tthanhtung1140003/vision-guided-tactile-gripper/firmware/readme.md

# Firmware

This folder contains the low-level firmware for the two STM32-based controllers in the vision-guided tactile gripper system:

- **gantry/**: Firmware for the 3-axis gantry CNC controller (STM32F103C8Tx).
- **gripper/**: Firmware for the parallel gripper controller (STM32 Blackpill).

Both are responsible for real-time motion control, communication, and safety features.

## Overview

| Controller | MCU | Communication | Main Functions | Project Type |
|---|---|---|---|---|
| Gantry | STM32F103C8Tx | USB Serial (from Laptop GUI) | Homing, jogging, motion planning, limits, error handling | STM32CubeIDE (.ioc) |
| Gripper | STM32 Blackpill  | USB Serial (from Raspberry Pi) | Grip/release, PID position/force, encoder reading | Arduino (.ino) |

## Folder Structure

```text
gantry/
├── App/                      # Application layer (custom logic)
│   ├── comm/                 # Serial communication protocol
│   │   ├── comm.c
│   │   └── comm.h
│   ├── driver/               # Hardware drivers
│   │   ├── driver.c
│   │   └── driver.h
│   ├── error/                # Error management
│   │   ├── error.c
│   │   └── error.h
│   ├── homing/               # Homing sequence
│   │   ├── homing.c
│   │   └── homing.h
│   ├── jog/                  # Jogging mode
│   │   ├── jog.c
│   │   └── jog.h
│   ├── limit/                # Limit switch handling
│   │   ├── limit.c
│   │   └── limit.h
│   ├── motion/               # Motion control core
│   │   ├── motion.c
│   │   └── motion.h
│   ├── protocol/             # Command parser
│   │   ├── protocol.c
│   │   └── protocol.h
│   ├── system/               # System init & tick
│   │   ├── system.c
│   │   └── system.h
│   ├── serial_rx.c
│   ├── serial_rx.h
│   ├── tick_1ms.c
│   └── tick_1ms.h
├── Core/                     # STM32Cube generated code
│   ├── Inc/                  # HAL headers
│   ├── Src/                  # HAL implementation
│   └── Startup/              # Startup assembly
├── Drivers/                  # CMSIS & STM32 HAL
├── Gantry Controller v10.ioc # CubeMX project file
├── STM32F103C8TX_FLASH.ld    # Linker script
└── Test.launch               # Debug configuration (optional)

gripper/
└── gripper.ino               # Main sketch: USB Serial, motor control, PID, encoder
```

## Communication Protocols

- **Gantry** → Receives G-code-like commands via USB Serial from Laptop GUI.  
  See: [protocols/serial_gantry_protocol.md](../protocols/serial_gantry_protocol.md)

- **Gripper** → Receives ASCII commands via USB Serial from Raspberry Pi.  
  See: [protocols/usb_gripper_protocol.md](../protocols/usb_gripper_protocol.md)

## Build & Flash Instructions

### For gantry/ (STM32CubeIDE)
1. Open `Gantry Controller v10.ioc` in STM32CubeIDE.
2. Generate code (if needed).
3. Build project (Ctrl+B).
4. Connect ST-Link → Debug/Run (F11) or Flash (hammer icon).

### For gripper/ (.ino)
1. Open `gripper.ino` in Arduino IDE (with STM32 core installed).
2. Select board (Generic STM32F1 series or Blackpill variant).
3. Select USB port → Upload.

**Note**: If using PlatformIO instead, create `platformio.ini` in each subfolder.

## Dependencies
- STM32Cube HAL (F1 series)
- CMSIS Core
- USB Device Library (for Serial on gripper, if implemented)
- Arduino STM32 core (for gripper.ino)

## Notes
- Gantry uses 1ms tick for precise timing (`tick_1ms.c`).
- All safety features (limits, error recovery, homing) are implemented in `App/` layer.
- Firmware is tightly coupled with hardware (pinout in `gpio.h` / `main.h`).

For detailed command format, error codes, and baudrate → refer to `protocols/` folder.

Firmware version: v1.0 (March 2026)  
Questions? Contact: tung.ntt215887@sis.hust.edu.vn
