tthanhtung1140003/vision-guided-tactile-gripper/protocols/serial_gantry_protocol.md

# Serial Gantry Protocol (Laptop → STM32)

G-code style:

- HOME
- G0 X100 Y200 Z50 F500
- JOG X+10
- STOP
- ACK
