tthanhtung1140003/vision-guided-tactile-gripper/docs/images/force_regression.png

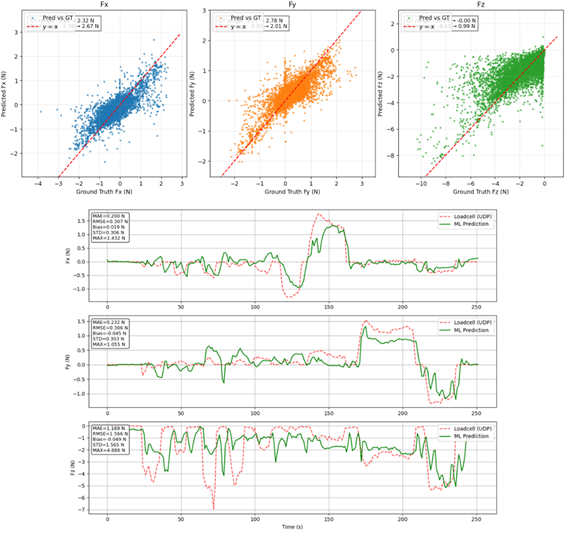
docs/images/force_regression.png
