tthanhtung1140003/vision-guided-tactile-gripper/docs/images/state_machine.png

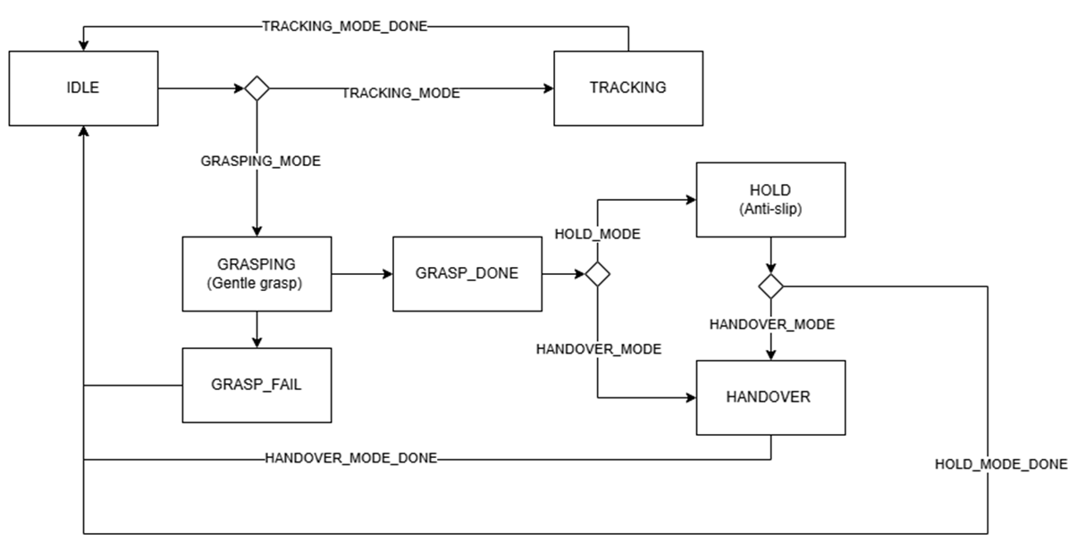
docs/images/state_machine.png
