tthanhtung1140003/vision-guided-tactile-gripper/laptop_gui/BG.png

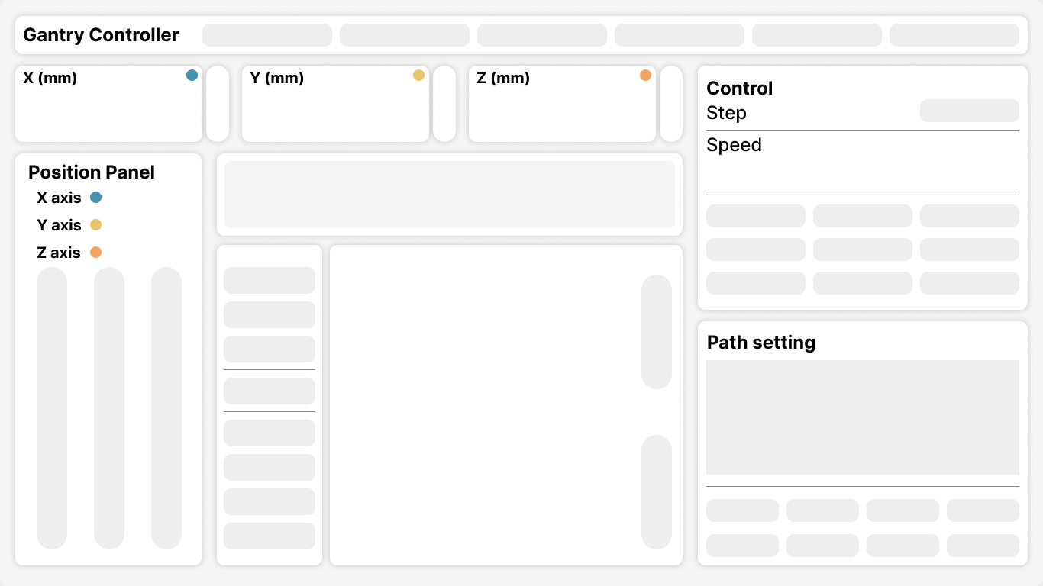
laptop_gui/BG.png
