tthanhtung1140003/vision-guided-tactile-gripper/model_train/pi_mlp_train/mlp_fcnn_style.png

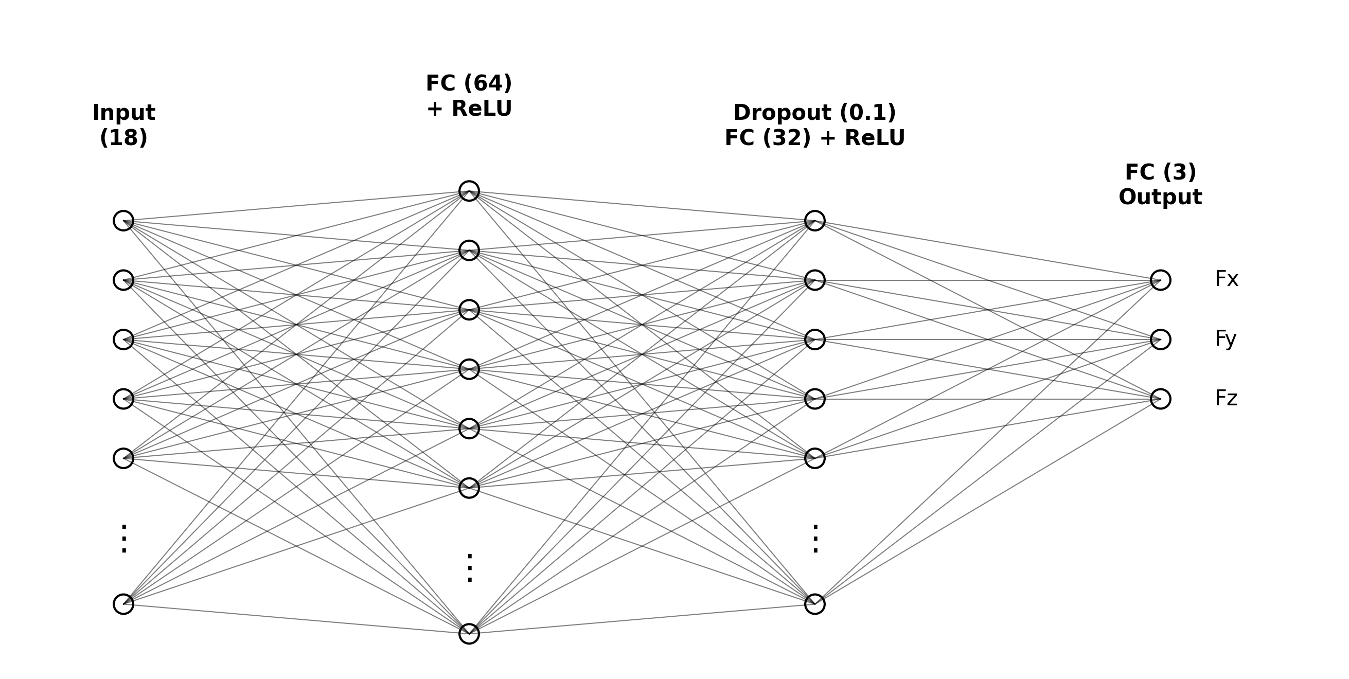
model_train/pi_mlp_train/mlp_fcnn_style.png
