tthanhtung1140003/vision-guided-tactile-gripper/model_train/pi_mlp_train/training_curve.png

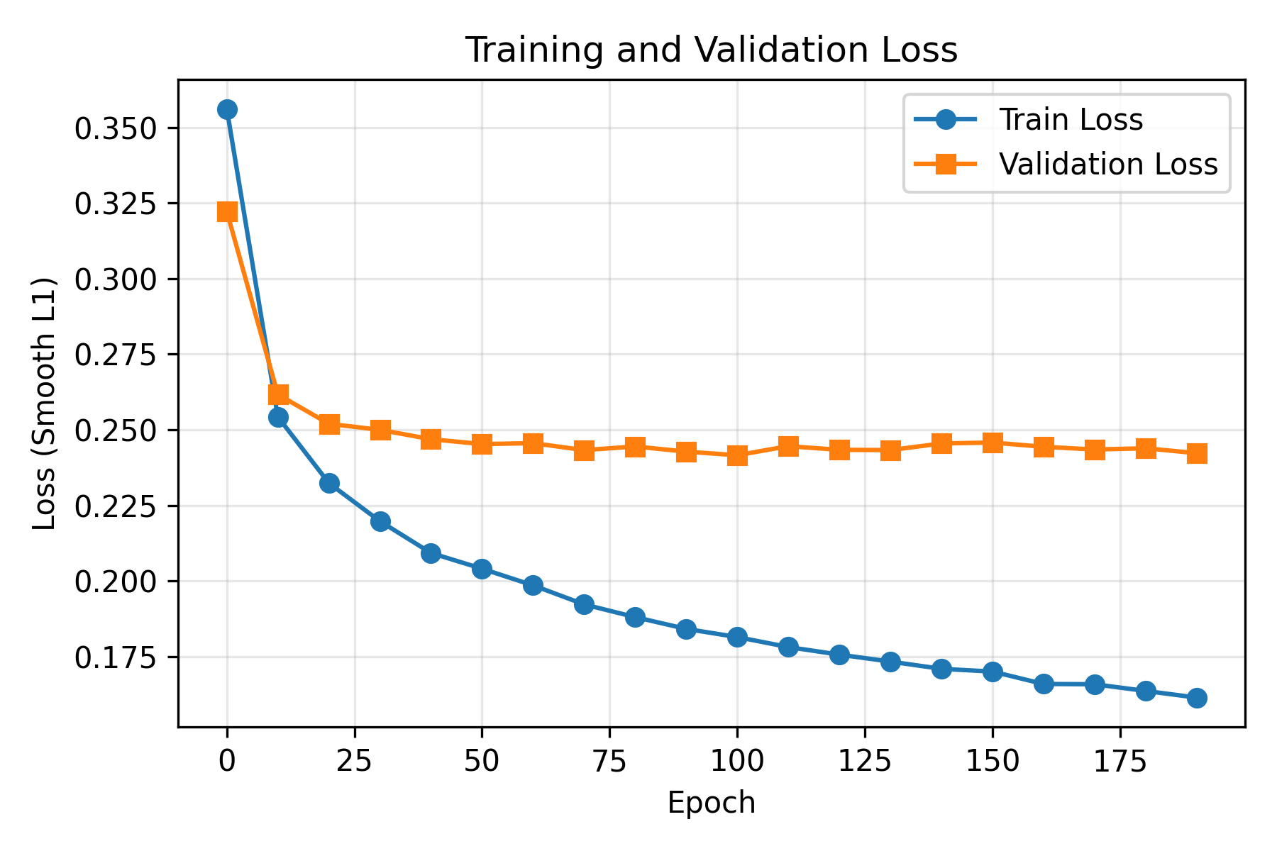
model_train/pi_mlp_train/training_curve.png
