tthanhtung1140003/vision-guided-tactile-gripper/docs/images/gripper_assembly.png.jpg

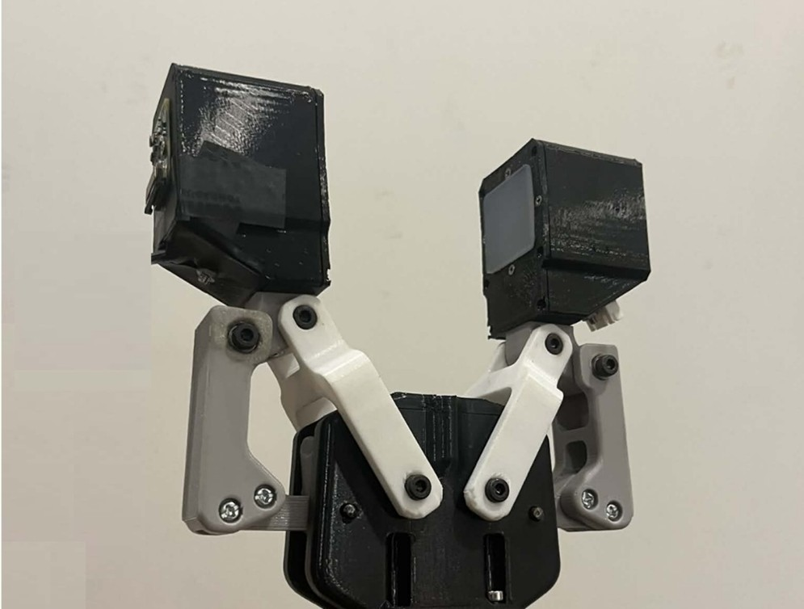
docs/images/gripper_assembly.png.jpg
