tthanhtung1140003/vision-guided-tactile-gripper/hardware/drawing/Model.pdf

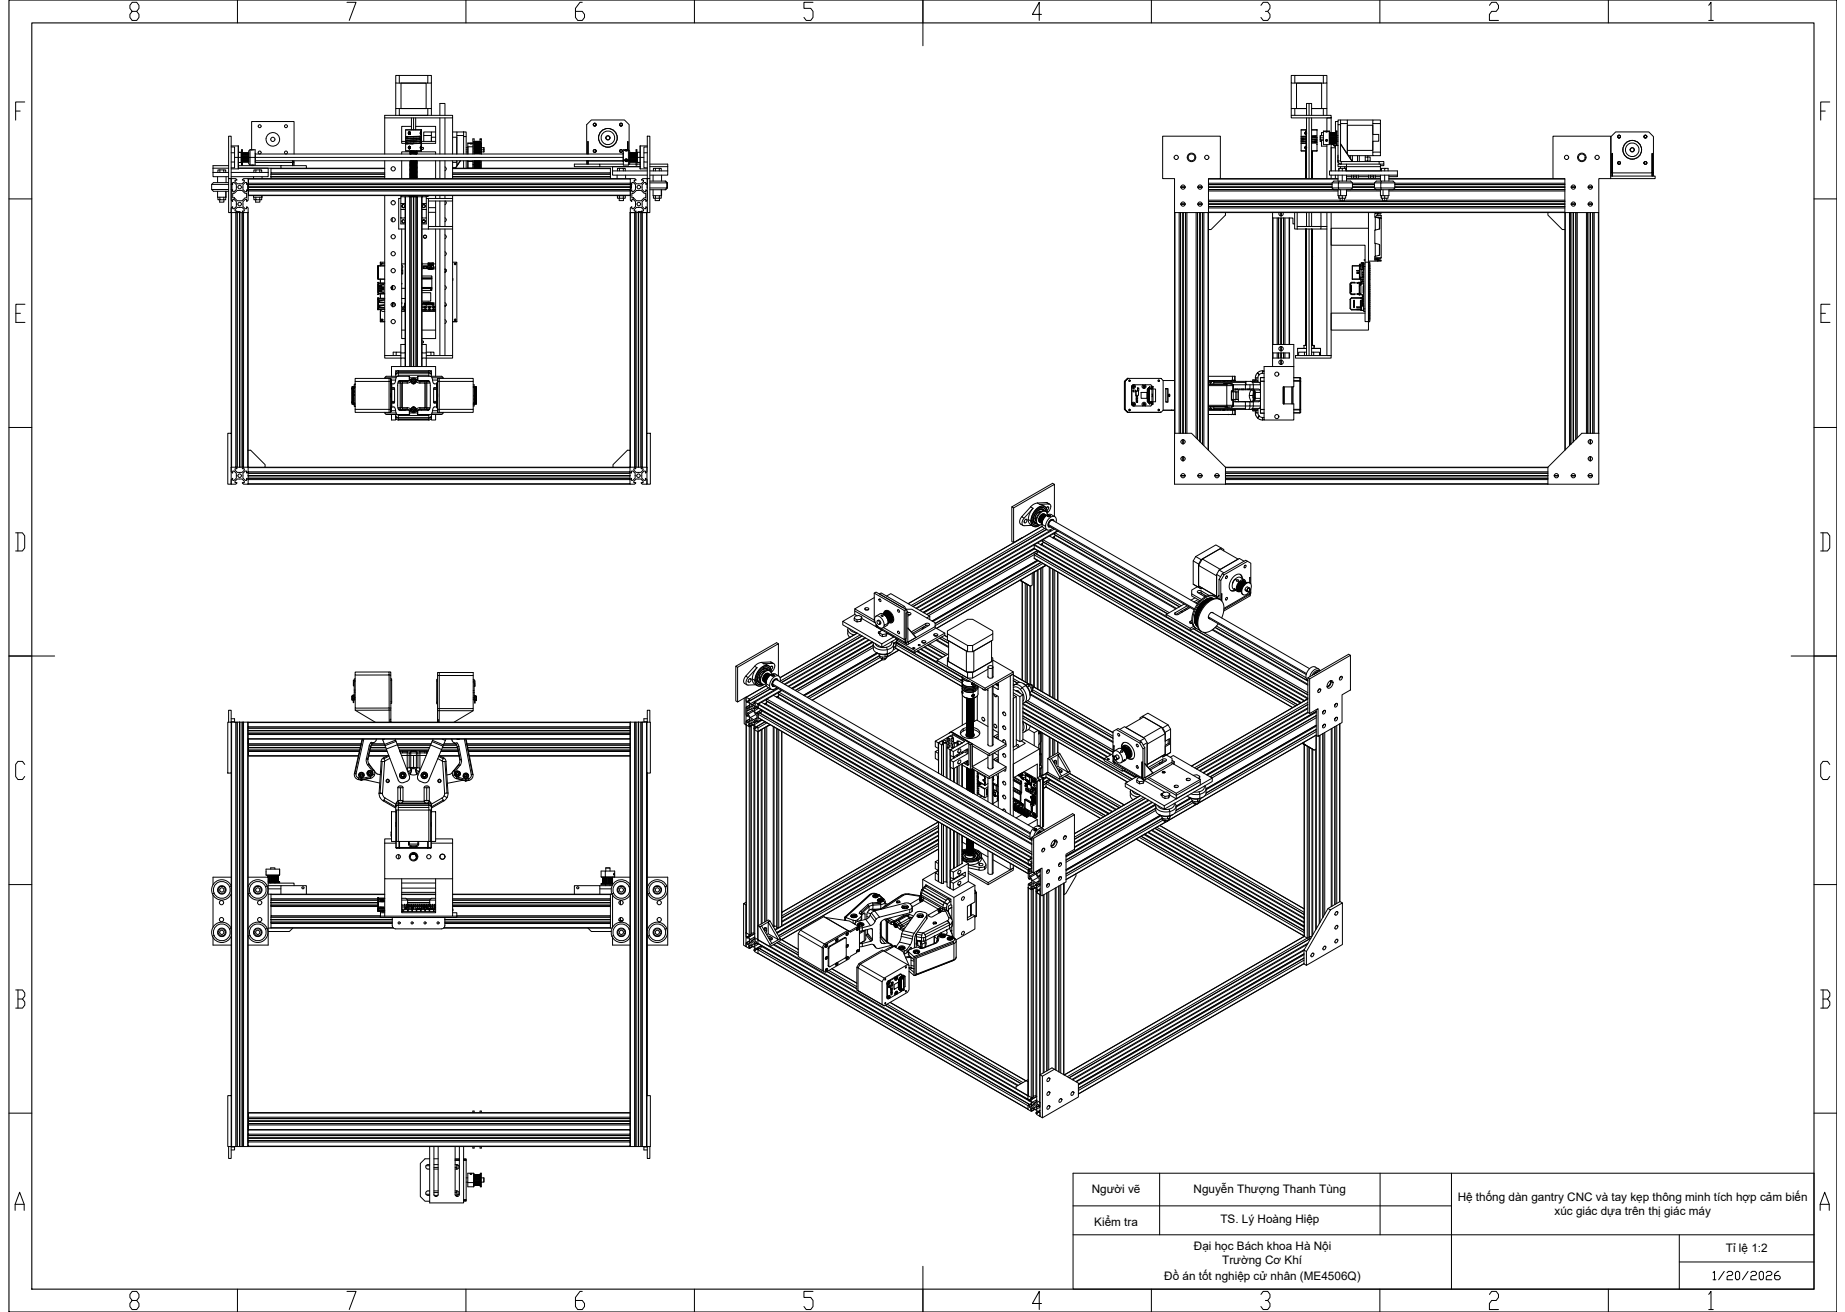
[picture p10: page 1]
Người vẽ; Nguyễn Thượng Thanh Tùng; Hệ thống dàn gantry CNC và tay kẹp thông minh tích hợp cảm biến xúc giác dựa trên thị giác máy Kiểm tra; TS. Lý Hoàng Hiệp Đại học Bách khoa Hà Nội Trường Cơ Khí Đồ án tốt nghiệp cử nhân (ME4506Q)
