tthanhtung1140003/vision-guided-tactile-gripper/hardware/drawing/Gripper-Model.pdf

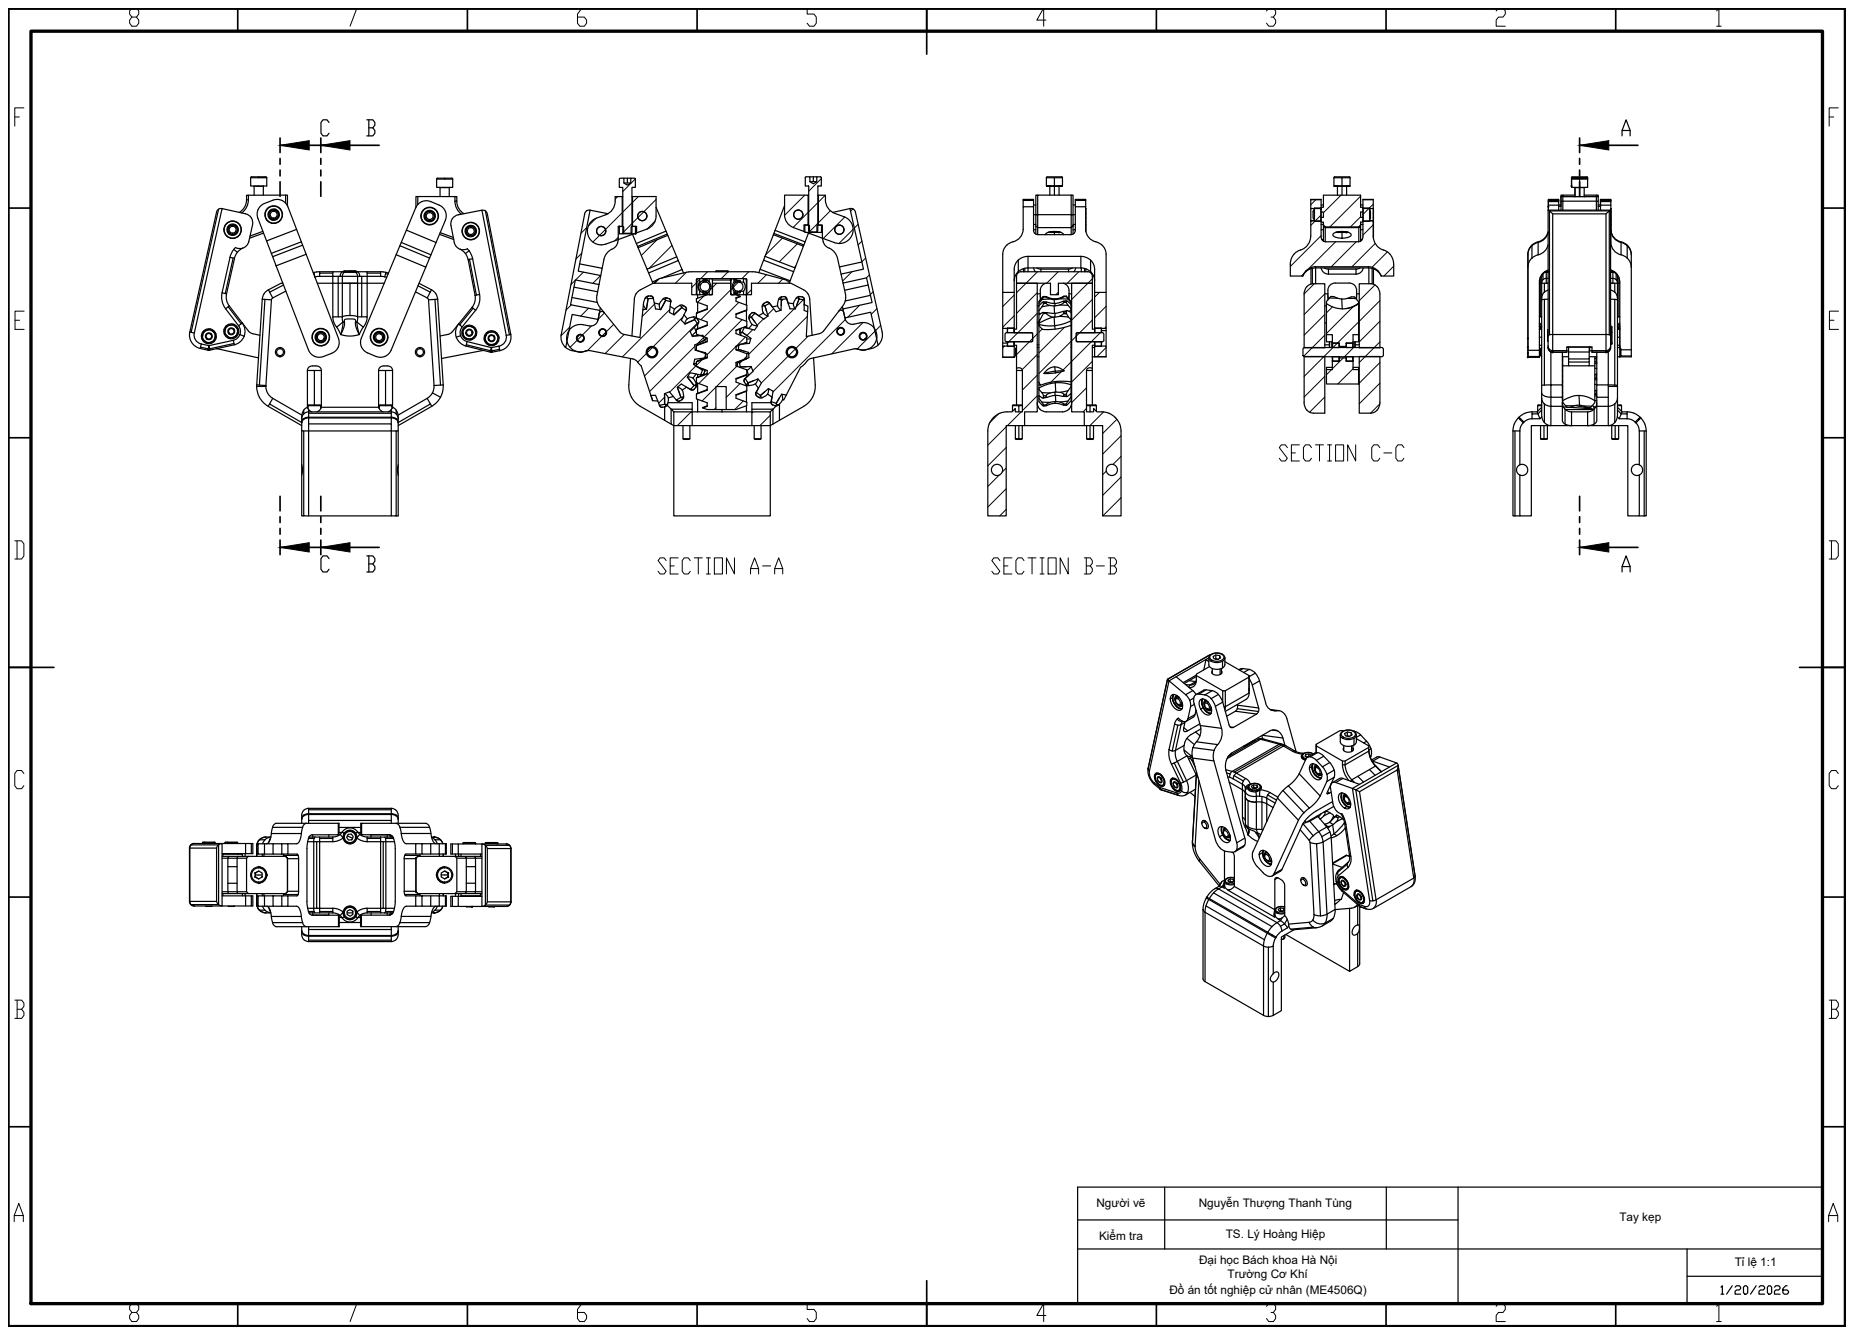
[picture p11: page 1]
Người vẽ; Nguyễn Thượng Thanh Tùng; Tay kẹp Kiểm tra; TS. Lý Hoàng Hiệp Đại học Bách khoa Hà Nội Trường Cơ Khí Đồ án tốt nghiệp cử nhân (ME4506Q)
