tthanhtung1140003/vision-guided-tactile-gripper/hardware/drawing/VBTS-Model.pdf

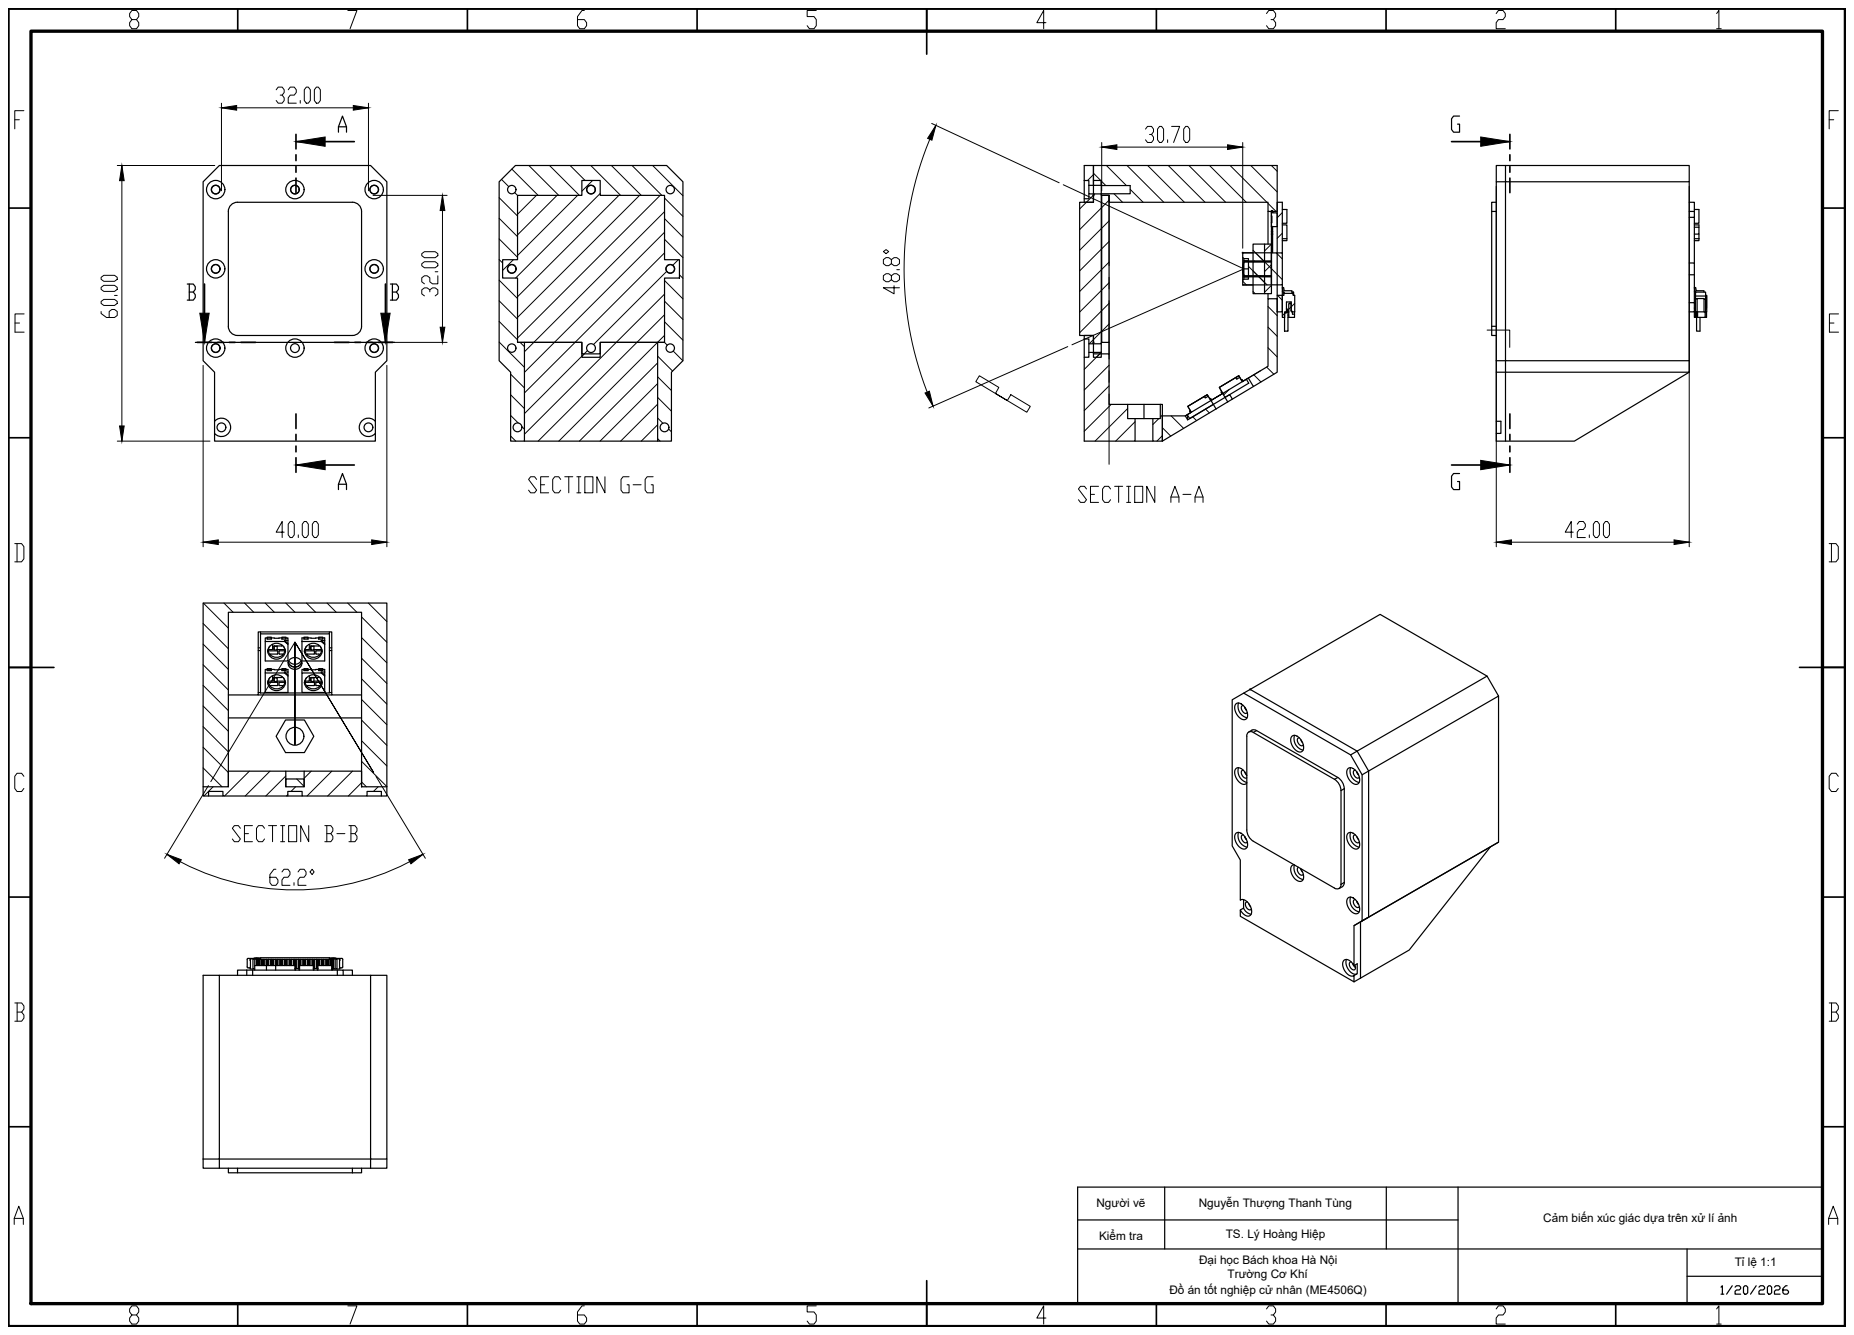
[picture p12: page 1]
Người vẽ; Nguyễn Thượng Thanh Tùng; Cảm biến xúc giác dựa trên xử lí ảnh Kiểm tra; TS. Lý Hoàng Hiệp Đại học Bách khoa Hà Nội Trường Cơ Khí Đồ án tốt nghiệp cử nhân (ME4506Q)
