tthanhtung1140003/vision-guided-tactile-gripper/firmware/gantry/Core/Inc/main.h

#define X_step_Pin GPIO_PIN_0
#define X_step_GPIO_Port GPIOA
#define X_dir_Pin GPIO_PIN_1
#define X_dir_GPIO_Port GPIOA
#define Y_step_Pin GPIO_PIN_3
#define Y_step_GPIO_Port GPIOA
#define Y_dir_Pin GPIO_PIN_4
#define Y_dir_GPIO_Port GPIOA
#define Z_step_Pin GPIO_PIN_6
#define Z_step_GPIO_Port GPIOA
#define Z_dir_Pin GPIO_PIN_7
#define Z_dir_GPIO_Port GPIOA
#define X_min_Pin GPIO_PIN_0
#define X_min_GPIO_Port GPIOB
#define X_max_Pin GPIO_PIN_1
#define X_max_GPIO_Port GPIOB
#define Y_min_Pin GPIO_PIN_10
#define Y_min_GPIO_Port GPIOB
#define Y_max_Pin GPIO_PIN_11
#define Y_max_GPIO_Port GPIOB
#define Z_min_Pin GPIO_PIN_12
#define Z_min_GPIO_Port GPIOB
#define Z_max_Pin GPIO_PIN_13
#define Z_max_GPIO_Port GPIOB
#define STEP_X_Pin        X_step_Pin
#define STEP_X_GPIO_Port  X_step_GPIO_Port
#define DIR_X_Pin         X_dir_Pin
#define DIR_X_GPIO_Port   X_dir_GPIO_Port
#define STEP_Y_Pin        Y_step_Pin
#define STEP_Y_GPIO_Port  Y_step_GPIO_Port
#define DIR_Y_Pin         Y_dir_Pin
#define DIR_Y_GPIO_Port   Y_dir_GPIO_Port
#define STEP_Z_Pin        Z_step_Pin
#define STEP_Z_GPIO_Port  Z_step_GPIO_Port
#define DIR_Z_Pin         Z_dir_Pin
#define DIR_Z_GPIO_Port   Z_dir_GPIO_Port
#define X_MIN_Pin         X_min_Pin
#define X_MIN_GPIO_Port   X_min_GPIO_Port
#define X_MAX_Pin         X_max_Pin
#define X_MAX_GPIO_Port   X_max_GPIO_Port
#define Y_MIN_Pin         Y_min_Pin
#define Y_MIN_GPIO_Port   Y_min_GPIO_Port
#define Y_MAX_Pin         Y_max_Pin
#define Y_MAX_GPIO_Port   Y_max_GPIO_Port
#define Z_MIN_Pin         Z_min_Pin
#define Z_MIN_GPIO_Port   Z_min_GPIO_Port
#define Z_MAX_Pin         Z_max_Pin
#define Z_MAX_GPIO_Port   Z_max_GPIO_Port
