tthanhtung1140003/vision-guided-tactile-gripper/firmware/gantry/Core/Inc/gpio.h

#ifndef __GPIO_H__
#define __GPIO_H__

#ifdef __cplusplus
extern "C" {
#endif

#include "main.h"

/* GPIO Initialization */
void MX_GPIO_Init(void);

#ifdef __cplusplus
}
#endif

#endif /* __GPIO_H__ */
