tthanhtung1140003/vision-guided-tactile-gripper/firmware/gantry/Core/Inc/usart.h

#ifndef __USART_H__
#define __USART_H__

#ifdef __cplusplus
extern "C" {
#endif

#include "stm32f1xx_hal.h"

extern UART_HandleTypeDef huart1;

void MX_USART1_UART_Init(void);

#ifdef __cplusplus
}
#endif

#endif /* __USART_H__ */
