tthanhtung1140003/vision-guided-tactile-gripper/laptop_gui/core/state.py

class SystemState:
    def __init__(self):
        self.pos = [0.0, 0.0, 0.0]
        self.last_pos_ts = 0.0  # monotonic timestamp when POS last updated
        self.estimate_pos = False  # when True, UI may estimate pos from target during tracking
        self.speed = [0.0, 0.0, 0.0]
        self.limits = "---"
        self.target_pos = [0.0, 0.0, 0.0]  
        self.fw_state = None  
        self.fw_err = None   
        self.connected = False
        self.points = []   
        self.paths = {}
        self.active_point_index = -1
